AxionQc/Protocontroller-Neo/Protocontroller.kicad_pcb

## KiCad design Protocontroller.kicad_pcb (2025-10-01)

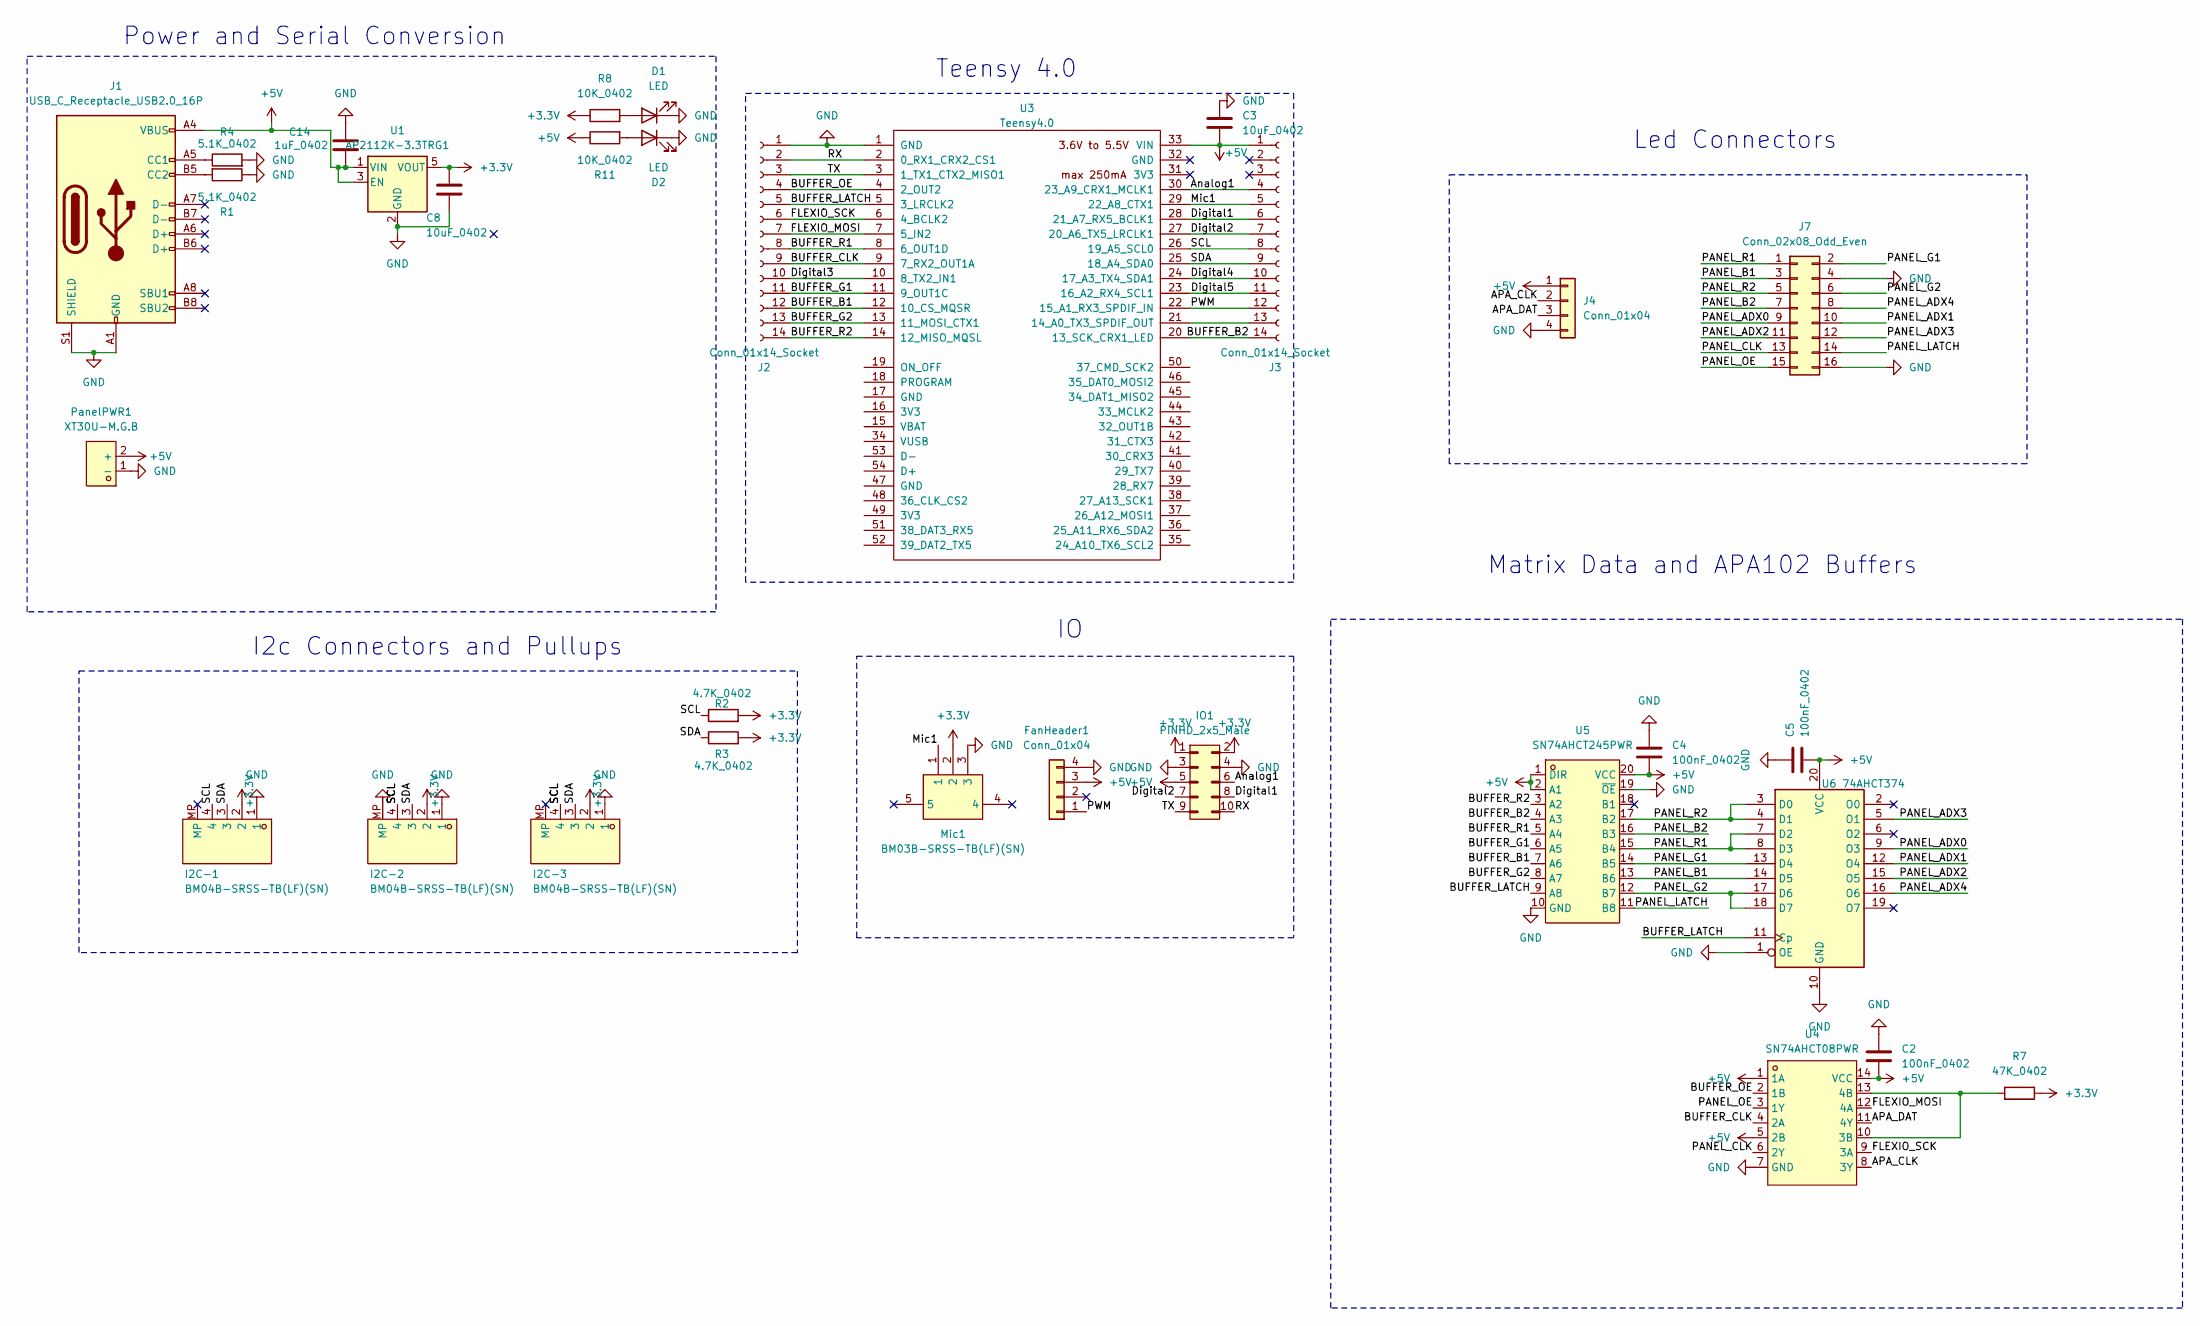
[picture p1: schematic Protocontroller.kicad_sch, Protocontroller Neo]

Parts:
C2, C4, C5: 100nF_0402; C_0402_1005Metric; JLC C1525
C3: 10uF_0402; C_0402_1005Metric; LCSC Part C15525
C8: 10uF_0402; C_0402_1005Metric; JLC C15525
C14: 1uF_0402; C_0402_1005Metric; LCSC Part C52923
D1, D2: LED; LED_0603_1608Metric; JLC C7496831
FanHeader1: Conn_01x04; PinHeader_1x04_P2.54mm_Vertical; JLC C2691448
I2C-1, I2C-2, I2C-3: BM04B-SRSS-TB(LF)(SN); CONN-SMD_BM04B-SRSS-TB; LCSC Part C160390
IO1: PINHD_2x5_Male; PinHeader_2x05_P2.54mm_Horizontal; JLC C5383090
J1: USB_C_Receptacle_USB2.0_16P; USB-TH_TYPE-C-16PFS-LCH7.45-IPX8; LCSC Part C3020054
J2, J3: Conn_01x14_Socket; PinSocket_1x14_P2.54mm_Vertical; JLC C2897377
J4: Conn_01x04; JST_SM 1x04 Pad
J7: Conn_02x08_Odd_Even; IDC-Header_2x08_P2.54mm_Horizontal; JLC C7430324
Mic1: BM03B-SRSS-TB(LF)(SN); JST_SH_BM03B-SRSS-TB_1x03-1MP_P1.00mm_Vertical; LCSC Part C160389
PanelPWR1: XT30U-M.G.B; AMASS_XT30U-M_1x02_P5.0mm_Vertical; LCSC Part C19268020
R1, R4: 5.1K_0402; R_0402_1005Metric; LCSC Part C25905
R2, R3: 4.7K_0402; R_0402_1005Metric; LCSC Part C25900
R7: 47K_0402; R_0402_1005Metric; JLC C25792
R8, R11: 10K_0402; R_0402_1005Metric; LCSC Part C25744
U1: AP2112K-3.3TRG1; SOT-23-5
U3: Teensy4.0; Teensy40_SMT
U4: SN74AHCT08PWR; TSSOP-14_L5.0-W4.4-P0.65-LS6.4-BL; LCSC Part C155175
U5: SN74AHCT245PWR; TSSOP-20_L6.5-W4.4-P0.65-LS6.4-BL; LCSC Part C10910
U6: 74AHCT374; SN74AHCT374PWR; JLC C141313

Connections:
+3.3V: C8.1, I2C-1.2, I2C-2.2, I2C-3.2, IO1.1, IO1.2, Mic1.2, R2.2, R3.2, R7.1, R8.1, U1.5 (VOUT)
+5V: C2.2, C3.2, C4.2, C5.2, C14.1, FanHeader1.3, IO1.5, J1.A4 (VBUS), J1.A9 (VBUS), J1.B4 (VBUS), J1.B9 (VBUS), J3.1, J4.1, PanelPWR1.2 (+), R11.1, U1.1 (VIN), U1.3 (EN), U3.33 (VIN), U4.1 (1A), U4.5 (2B), U4.14 (VCC), U5.1 (DIR), U5.2 (A1), U5.20 (VCC), U6.20 (VCC)
/APA_CLK: J4.2, U4.8 (3Y)
/APA_DAT: J4.3, U4.11 (4Y)
/Analog1: IO1.6, J3.4, U3.30 (23_A9_CRX1_MCLK1)
/BUFFER_B1: J2.12, U3.12 (10_CS_MQSR), U5.7 (A6)
/BUFFER_B2: J3.14, U3.20 (13_SCK_CRX1_LED), U5.4 (A3)
/BUFFER_CLK: J2.9, U3.9 (7_RX2_OUT1A), U4.4 (2A)
/BUFFER_G1: J2.11, U3.11 (9_OUT1C), U5.6 (A5)
/BUFFER_G2: J2.13, U3.13 (11_MOSI_CTX1), U5.8 (A7)
/BUFFER_LATCH: J2.5, U3.5 (3_LRCLK2), U5.9 (A8), U6.11 (Cp)
/BUFFER_OE: J2.4, U3.4 (2_OUT2), U4.2 (1B)
/BUFFER_R1: J2.8, U3.8 (6_OUT1D), U5.5 (A4)
/BUFFER_R2: J2.14, U3.14 (12_MISO_MQSL), U5.3 (A2)
/Digital1: IO1.8, J3.6, U3.28 (21_A7_RX5_BCLK1)
/Digital2: IO1.7, J3.7, U3.27 (20_A6_TX5_LRCLK1)
/Digital3: J2.10, U3.10 (8_TX2_IN1)
/Digital4: J3.10, U3.24 (17_A3_TX4_SDA1)
/Digital5: J3.11, U3.23 (16_A2_RX4_SCL1)
/FLEXIO_MOSI: J2.7, U3.7 (5_IN2), U4.12 (4A)
/FLEXIO_SCK: J2.6, U3.6 (4_BCLK2), U4.9 (3A)
/Mic1: J3.5, Mic1.1, U3.29 (22_A8_CTX1)
/PANEL_ADX0: J7.9, U6.9 (O3)
/PANEL_ADX1: J7.10, U6.12 (O4)
/PANEL_ADX2: J7.11, U6.15 (O5)
/PANEL_ADX3: J7.12, U6.5 (O1)
/PANEL_ADX4: J7.8, U6.16 (O6)
/PANEL_B1: J7.3, U5.13 (B6), U6.14 (D5)
/PANEL_B2: J7.7, U5.16 (B3)
/PANEL_CLK: J7.13, U4.6 (2Y)
/PANEL_G1: J7.2, U5.14 (B5), U6.13 (D4)
/PANEL_G2: J7.6, U5.12 (B7), U6.17 (D6), U6.18 (D7)
/PANEL_LATCH: J7.14, U5.11 (B8)
/PANEL_OE: J7.15, U4.3 (1Y)
/PANEL_R1: J7.1, U5.15 (B4), U6.7 (D2), U6.8 (D3)
/PANEL_R2: J7.5, U5.17 (B2), U6.3 (D0), U6.4 (D1)
/PWM: FanHeader1.1, J3.12, U3.22 (15_A1_RX3_SPDIF_IN)
/RX: IO1.10, J2.2, U3.2 (0_RX1_CRX2_CS1)
/SCL: I2C-1.4, I2C-2.4, I2C-3.4, J3.8, R2.1, U3.26 (19_A5_SCL0)
/SDA: I2C-1.3, I2C-2.3, I2C-3.3, J3.9, R3.1, U3.25 (18_A4_SDA0)
/TX: IO1.9, J2.3, U3.3 (1_TX1_CTX2_MISO1)
GND: C2.1, C3.1, C4.1, C5.1, C8.2, C14.2, D1.1 (K), D2.1 (K), FanHeader1.4, I2C-1.1, I2C-2.1, I2C-2.MP, I2C-3.1, I2C-3.MP, IO1.3, IO1.4, J1.A1 (GND), J1.A12 (GND), J1.B1 (GND), J1.B12 (GND), J1.S1 (SHIELD), J2.1, J4.4, J7.4, J7.16, Mic1.3, PanelPWR1.1 (-), R1.1, R4.2, U1.2 (GND), U3.1 (GND), U4.7 (GND), U5.10 (GND), U5.19 (~OE), U6.1 (OE), U6.10 (GND)
unnamed: D1.2 (A), R8.2
unnamed: D2.2 (A), R11.2
unnamed: J1.A5 (CC1), R4.1
unnamed: J1.B5 (CC2), R1.2
unnamed: J3.13, U3.21 (14_A0_TX3_SPDIF_OUT)
unnamed: R7.2, U4.10 (3B), U4.13 (4B)

Notes on the sheet:
Matrix Data and APA102 Buffers
Led Connectors
Teensy 4.0
I2c Connectors and Pullups
Power and Serial Conversion

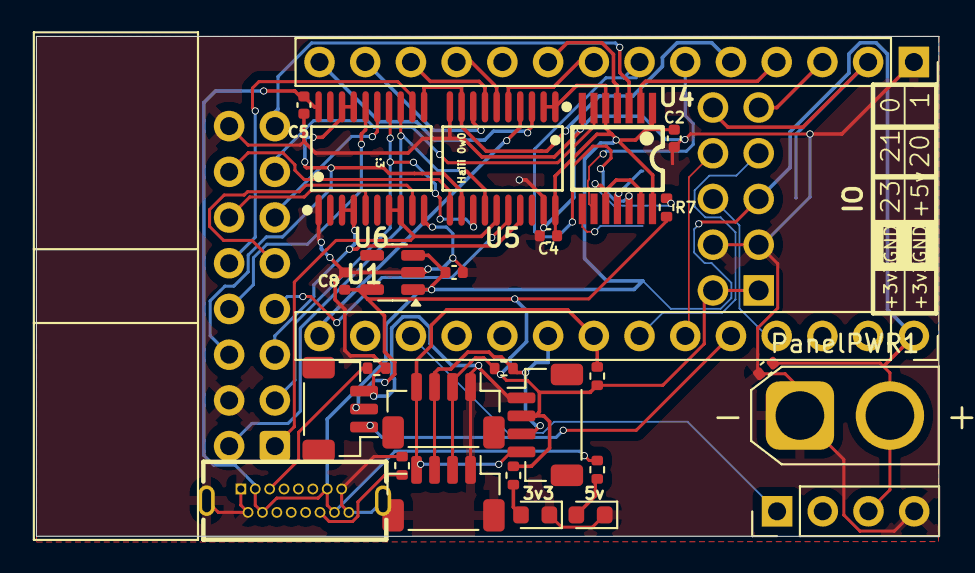
[picture p2: board Protocontroller.kicad_pcb from above]

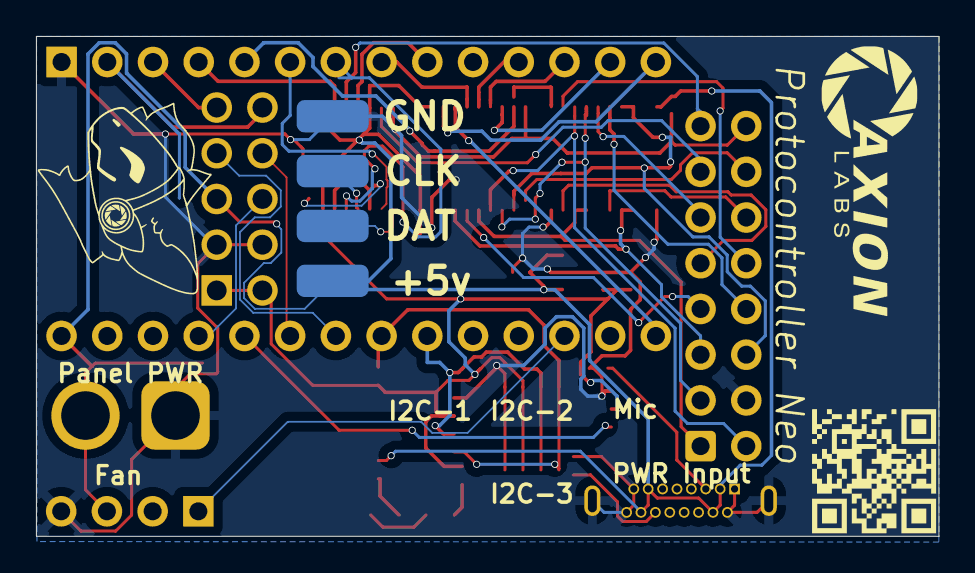
[picture p3: board Protocontroller.kicad_pcb from below]

Board: 2 copper layers, 50.1 x 27.8 mm, 33 parts (2 on the bottom side), 44 nets.

Other parts of the board:
AxionLogo: LOGO
Qr: LOGO
