AxionQc/Protocontroller-Neo/(commit log)

2025-05-31 Add everything
    [Protocontroller.kicad_pcb, Protocontroller.kicad_sch, bom.csv, designators.csv, positions.csv]
2025-06-01 Fix I2C, Pathing, and improve Silkscreen
    [Protocontroller.kicad_pcb, Protocontroller.kicad_sch, bom.csv, positions.csv]
2025-06-01 Fix 3v3 Trace
    [Protocontroller.kicad_pcb]
2025-06-01 Add Updated Gerber
2025-06-01 Remove WS35 Support, Adjust Traces, Fix issue with Panel out not actually being connected to anything
    [Protocontroller.kicad_pcb, Protocontroller.kicad_sch, bom.csv, positions.csv]
2025-06-01 Fix 3v3 Regulator having bad Rotation, Fix issue of Mic and Led's being replaced when updating from schematic.
    [Protocontroller.kicad_pcb, Protocontroller.kicad_sch, bom.csv, designators.csv, positions.csv]
2025-06-02 Switch Pullups to use 4.7k Resistors for improved speeds, Adjusted capacitors, removed Designators file
    [Protocontroller.kicad_pcb, Protocontroller.kicad_sch, bom.csv, designators.csv, positions.csv]
2025-06-03 Removed 0201 Resistors for Compatablity with Economic PCBA's, moved JST SH ports so I2C-1 Pins dont phase through teensy headers
    [Protocontroller.kicad_pcb, bom.csv, positions.csv]
2025-06-15 Fix Compat with Economic Again
    [Protocontroller.kicad_pcb]
2025-06-23 Fix Economic Again, fix R1 not being connected, V2 tba
    [Protocontroller.kicad_pcb, Protocontroller.kicad_sch, bom.csv, positions.csv]
2025-07-10 V2 of the neo released, switched stemma to stemma qt, adjusted io pinout, replaced secondary 74245 with the 7408, swapped apaclk and apadat, switched to 2 layer for cheaper costs, esp32 schematic in,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
    [Protocontroller.kicad_pcb, Protocontroller.kicad_sch, bom.csv, positions.csv]
2025-10-01 new layout, bunch of empty space
    [Protocontroller.kicad_pcb, Protocontroller.kicad_sch, bom.csv, positions.csv]
2025-10-01 fix files
    [Protocontroller.kicad_pcb, Protocontroller.kicad_sch, bom - semiauto.csv, positions - semiauto.csv]
2025-10-01 adjusted i2c position and ubc position
    [Protocontroller.kicad_pcb, bom.csv, positions - semiauto.csv, positions.csv]
